abdullahbaig1618/LED-Dice/x540TyO4ae.png

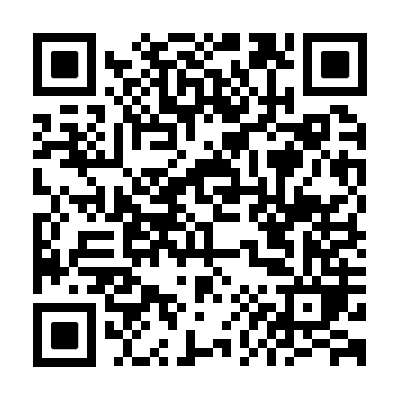
x540TyO4ae.png
