abdullahbaig1618/LED-Dice/casing/dice box.FCStd

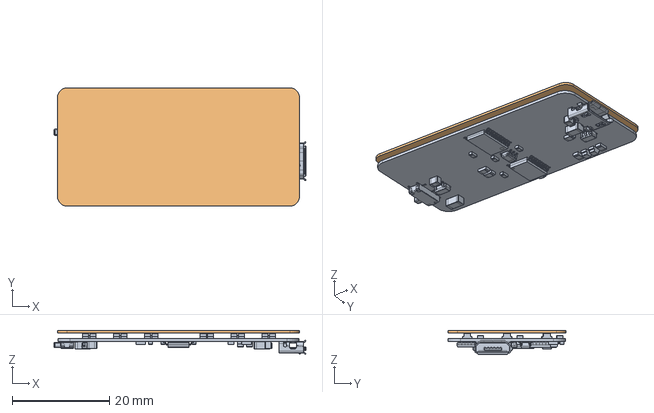
[picture p2: CAD file, 2025-08-02]
casing/dice box.FCStd
51.7 x 24.3 x 4.96 mm
board
