abdullahbaig1618/LED-Dice/circuits/LED Dice v1/LED Dice.step

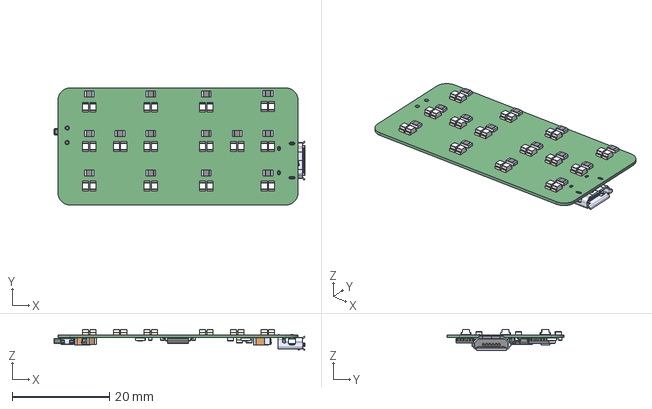
[picture p3: CAD file, 2026-06-17, an earlier design]
circuits/LED Dice v1/LED Dice.step
51.7 x 24.1 x 4.36 mm
