abdullahbaig1618/LED-Dice/circuits/LED Dice v2/LED Dice v2.pdf

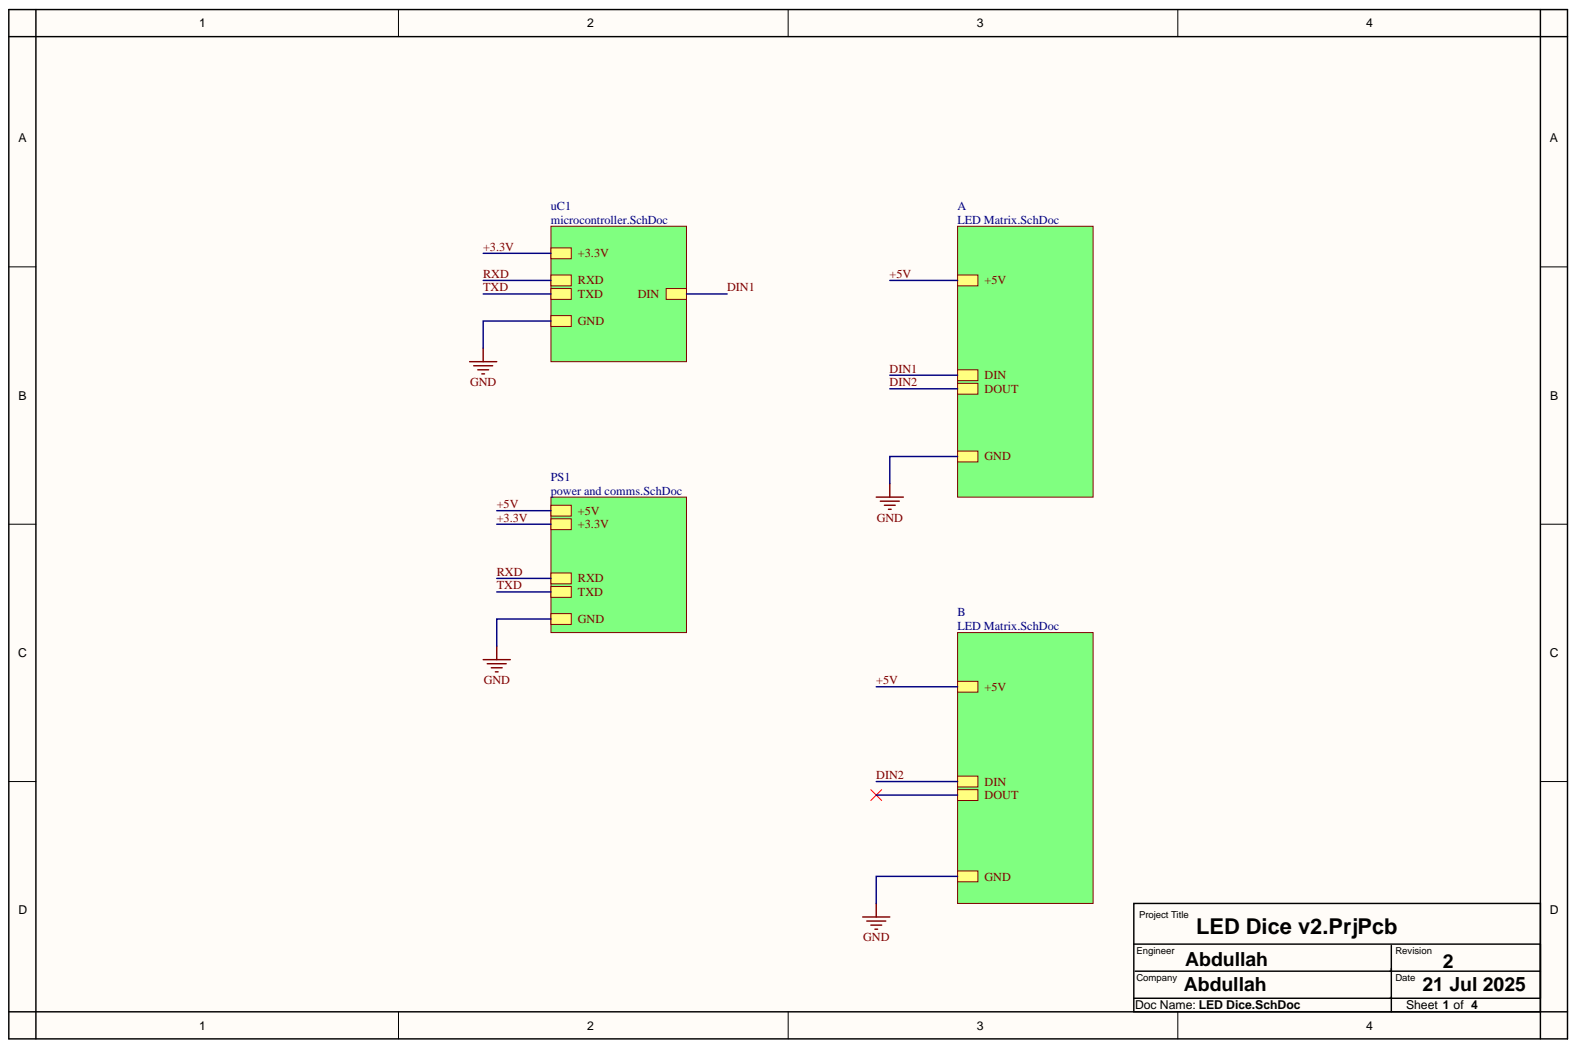
[picture p4: page 1]

A | uC1 A microcontroller.SchDoc LED Matrix.SchDoc | | | | A

LED Dice v2.PrjPcb Project Title

Engineer Abdullah | Revision
Company Abdullah | Sheet 1 of 4 2 Date 21 Jul 2025 Doc Name: LED Dice.SchDoc

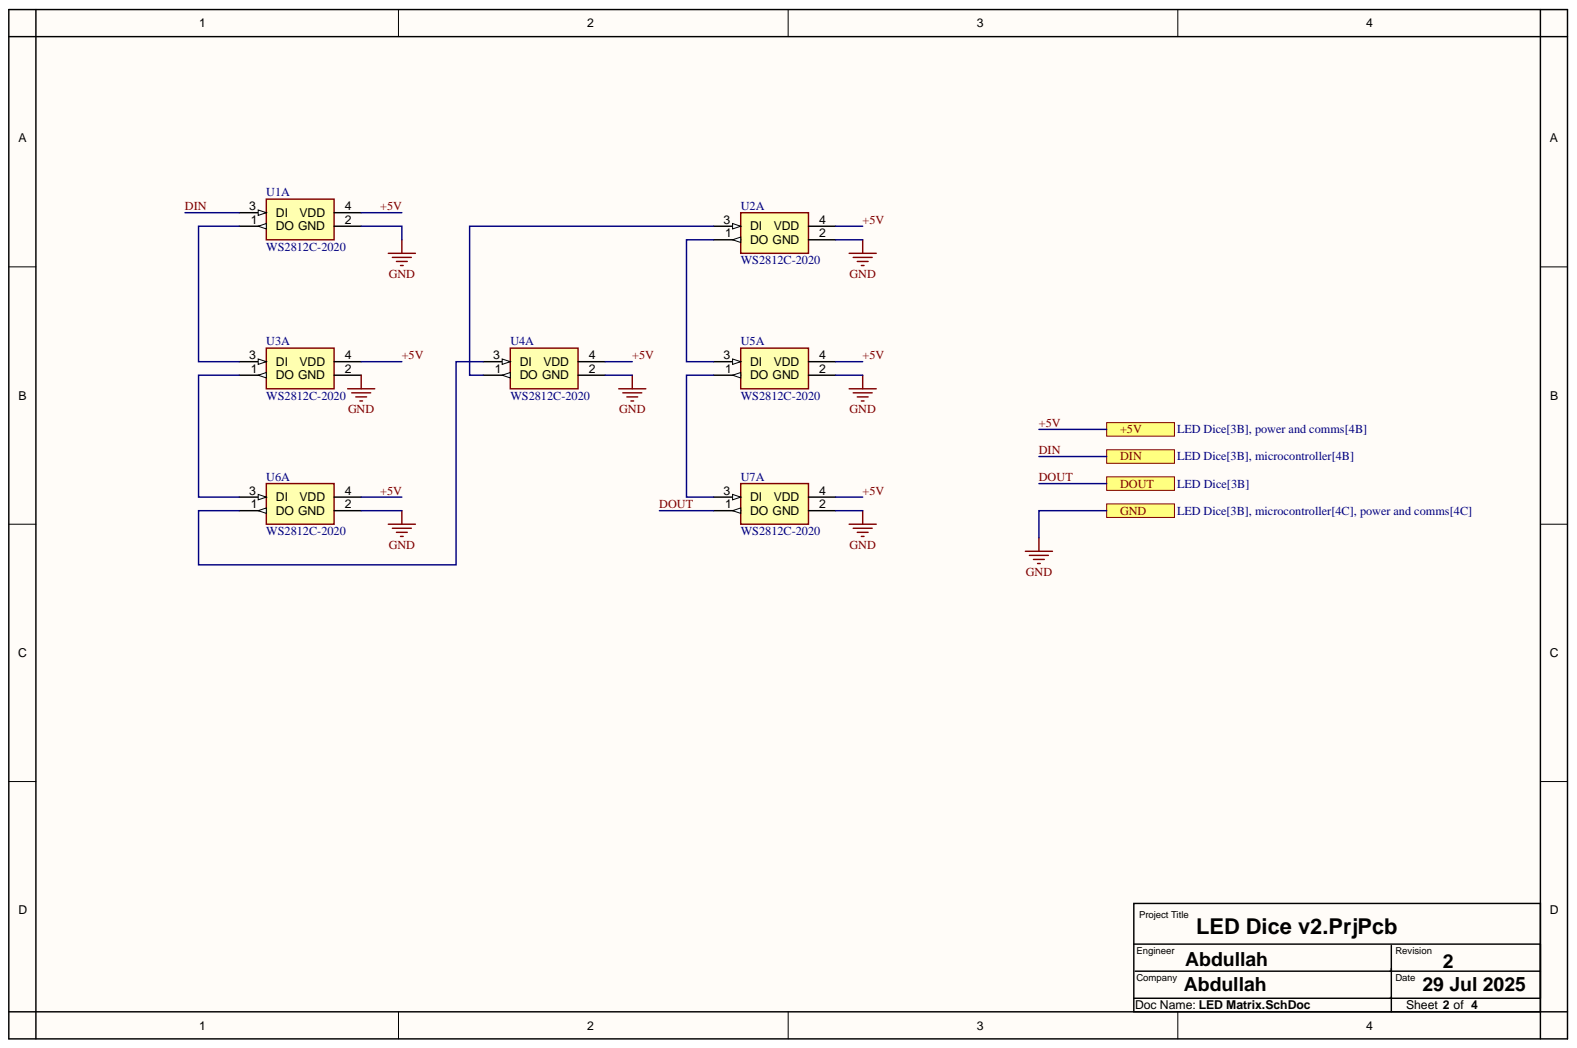
[picture p5: page 2]

LED Dice v2.PrjPcb Project Title

Engineer Abdullah | Revision
Company Abdullah | Sheet 2 of 4 2 Date 29 Jul 2025 Doc Name: LED Matrix.SchDoc

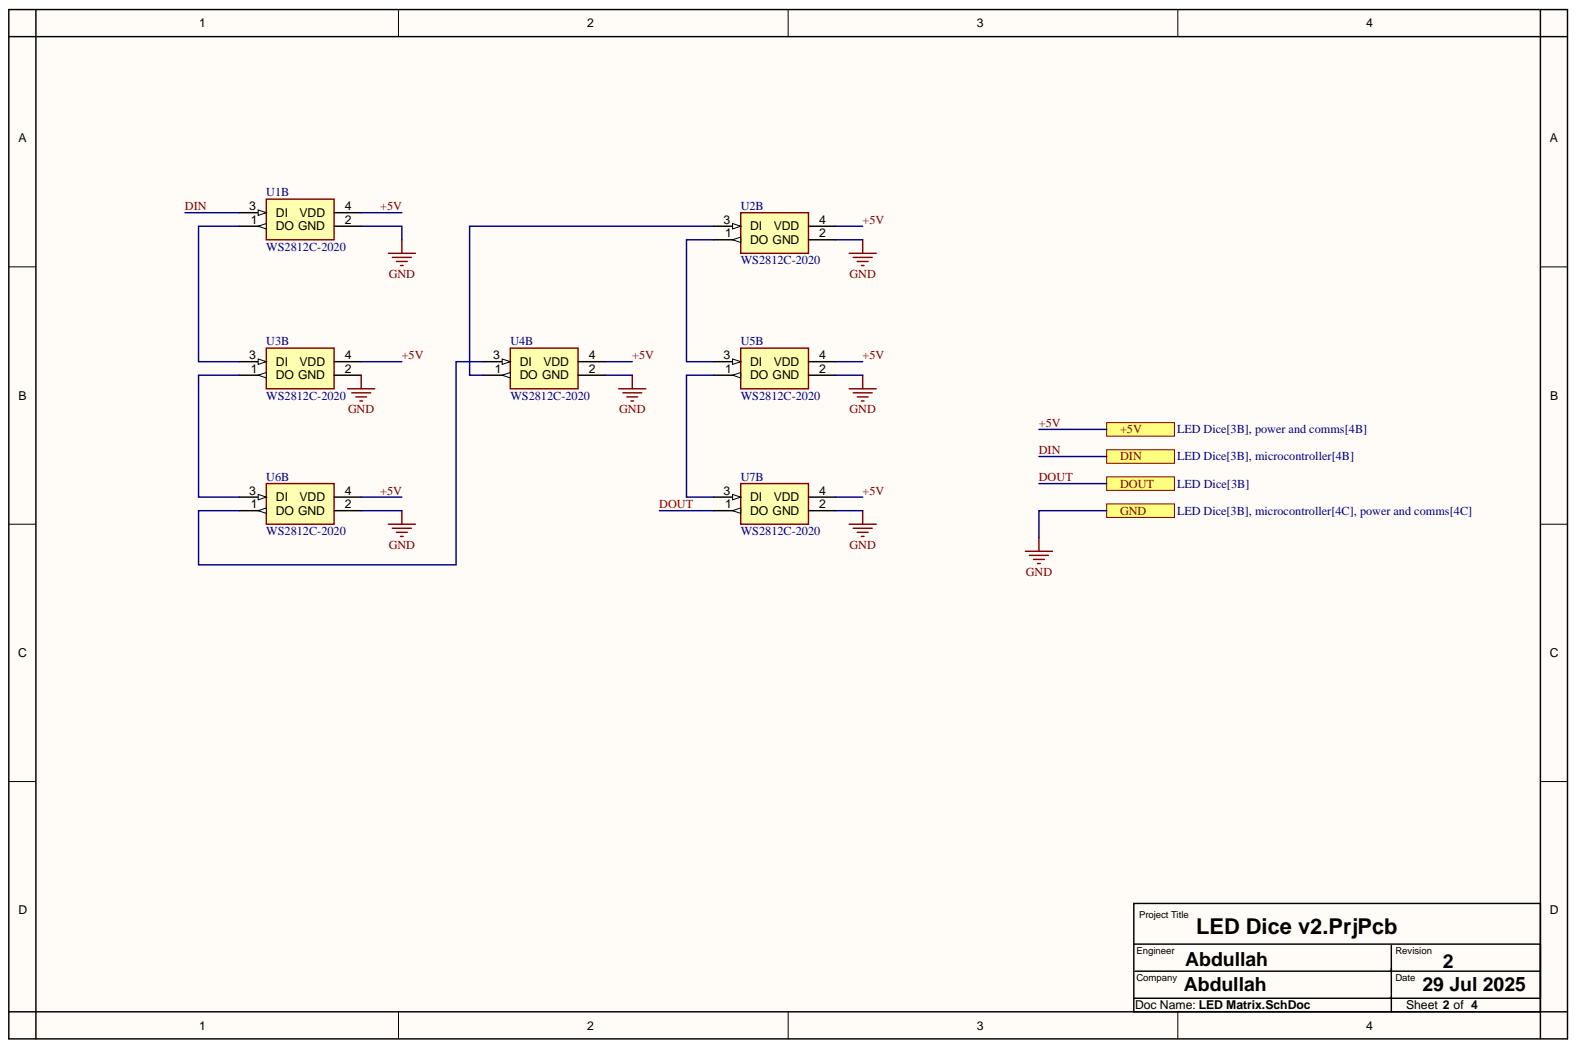
[picture p6: page 3]

LED Dice v2.PrjPcb Project Title

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

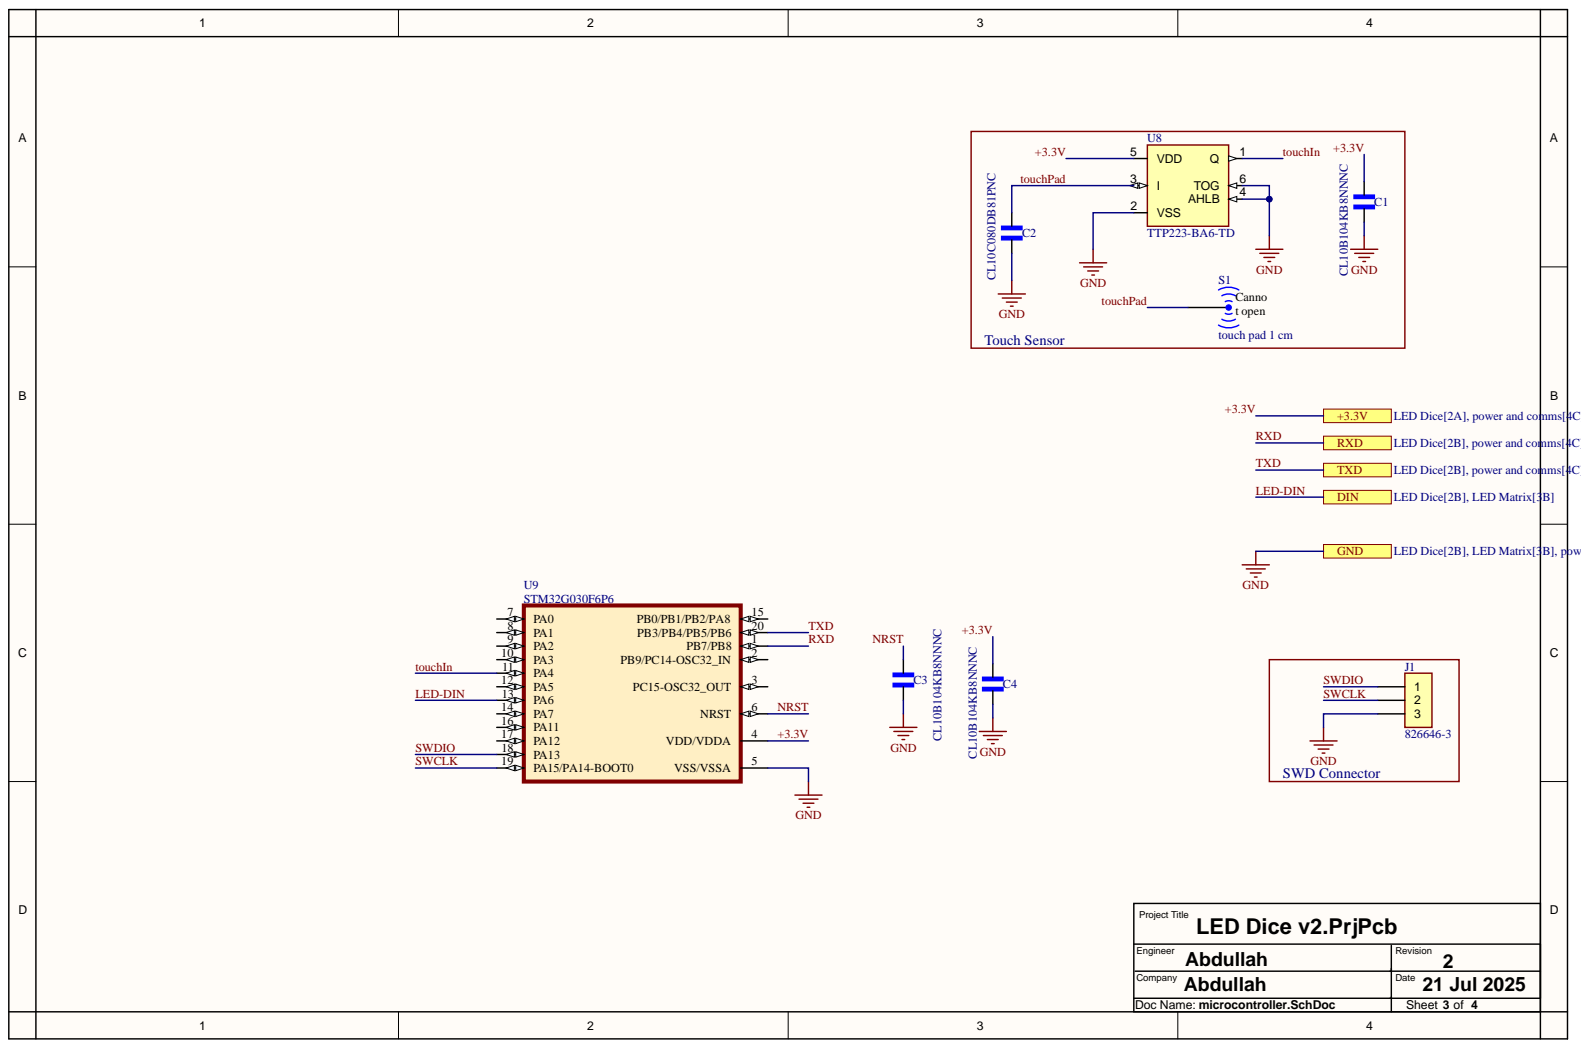
[picture p7: page 4]

LED Dice v2.PrjPcb Project Title

Engineer Abdullah | Revision
Company Abdullah | Sheet 3 of 4 2 Date 21 Jul 2025 Doc Name: microcontroller.SchDoc

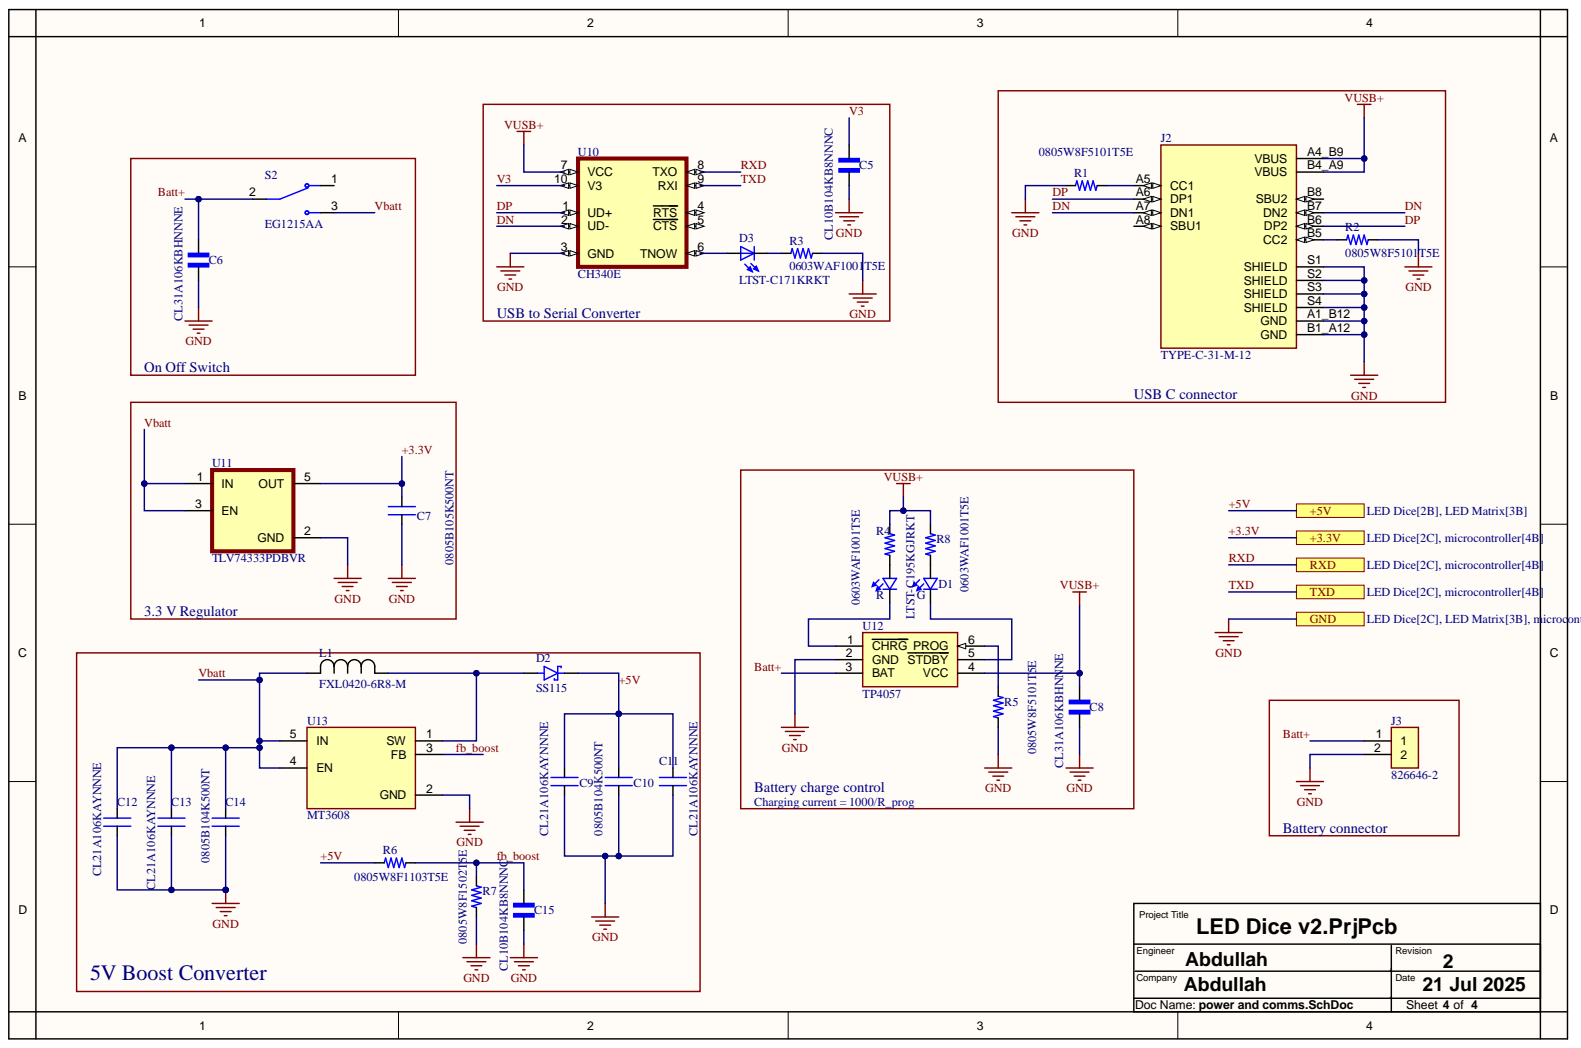
[picture p8: page 5]

USB to Serial Converter

CHRG 1 | STDBY
GND 2 | 5
BAT 3

LED Dice v2.PrjPcb Project Title

Engineer Abdullah | Revision
Company Abdullah | Sheet 4 of 4 2 Date 21 Jul 2025 Doc Name: power and comms.SchDoc

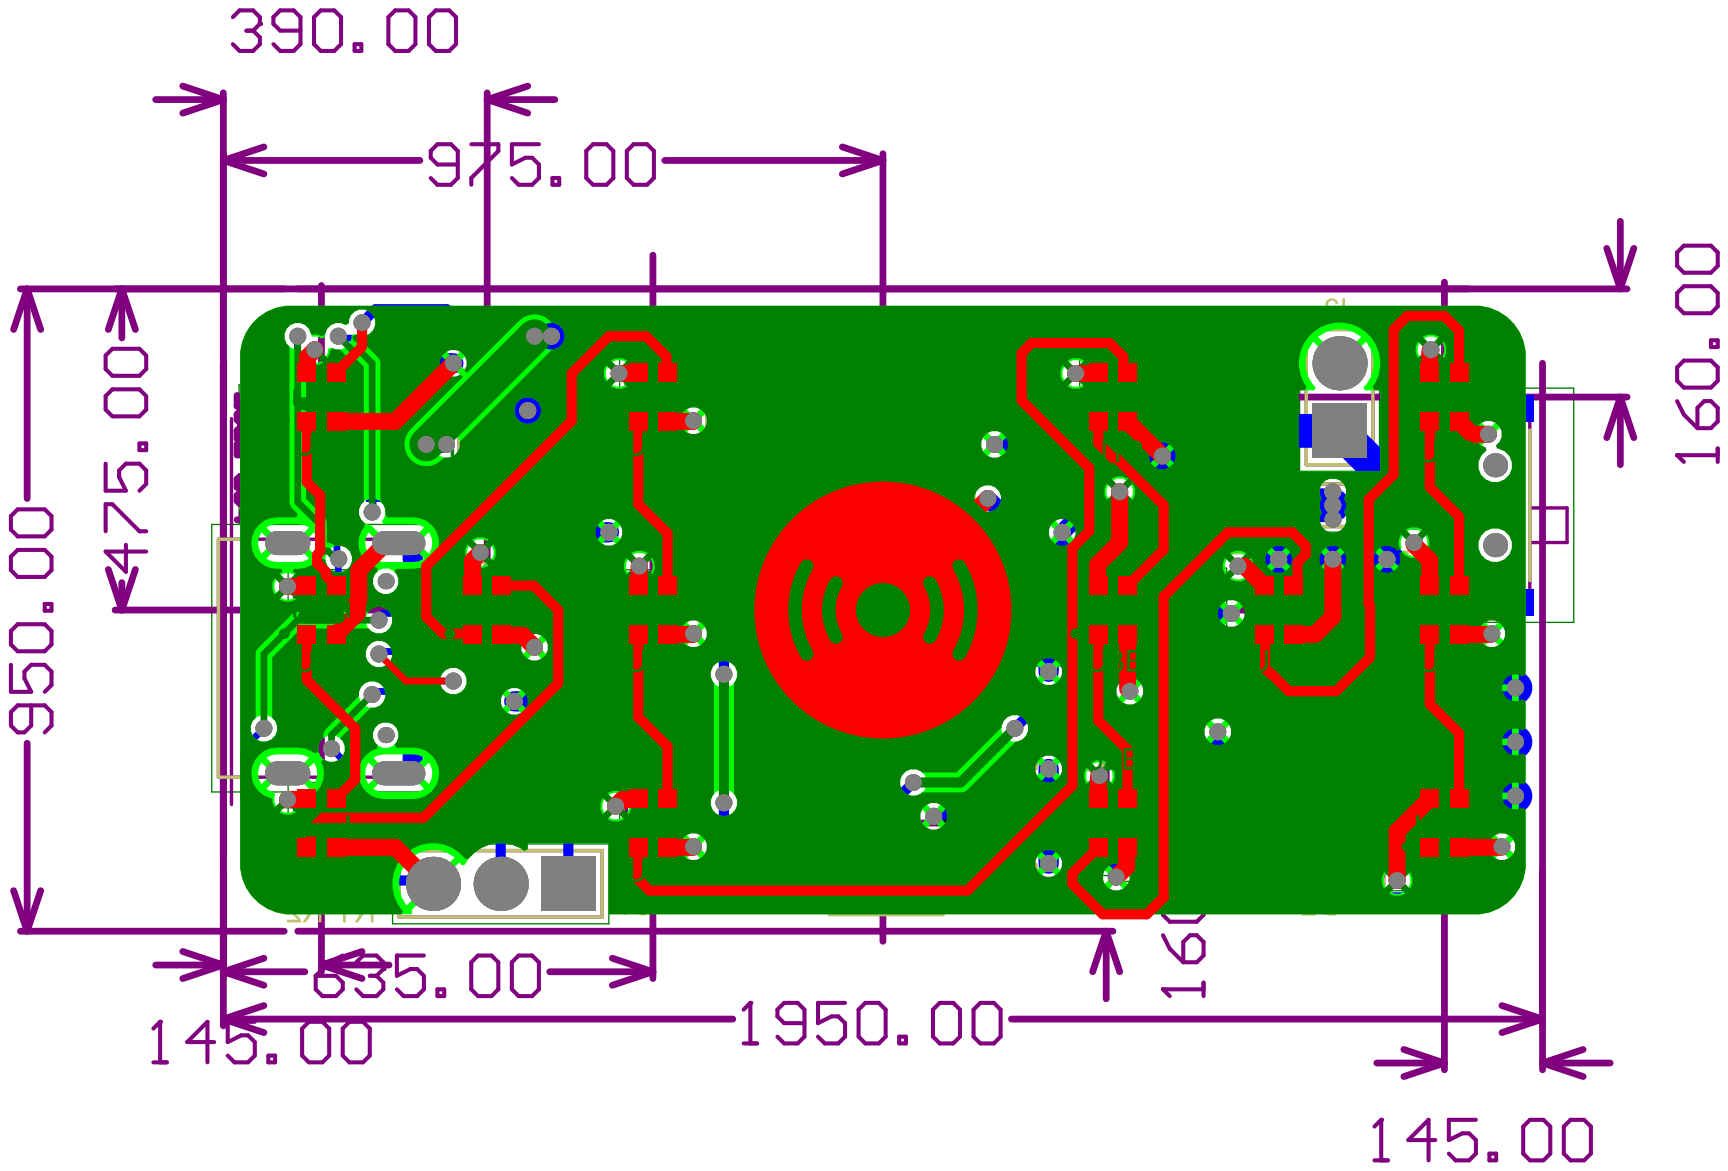
[picture p9: page 6]
