abdullahbaig1618/LED-Dice/(list of files, drawings)

Other design files:
circuits/LED Dice v1/LED Dice v1.PrjPcb
circuits/LED Dice v1/LED Dice.PcbDoc
circuits/LED Dice v1/LED Dice.SchDoc
circuits/LED Dice v1/LED Matrix.SchDoc
circuits/LED Dice v2/LED Dice v2.PrjPcb
circuits/LED Dice v2/LED Dice.PcbDoc
circuits/LED Dice v2/LED Dice.SchDoc
circuits/LED Dice v2/LED Matrix.SchDoc
circuits/LED Dice v2/microcontroller.SchDoc
circuits/LED Dice v2/power and comms.SchDoc
