abdullahbaig1618/LED-Dice/circuits/LED Dice v3/LED Dice/LED Dice.kicad_pcb

## KiCad design circuits/LED Dice v3/LED Dice/LED Dice.kicad_pcb (2026-06-24)

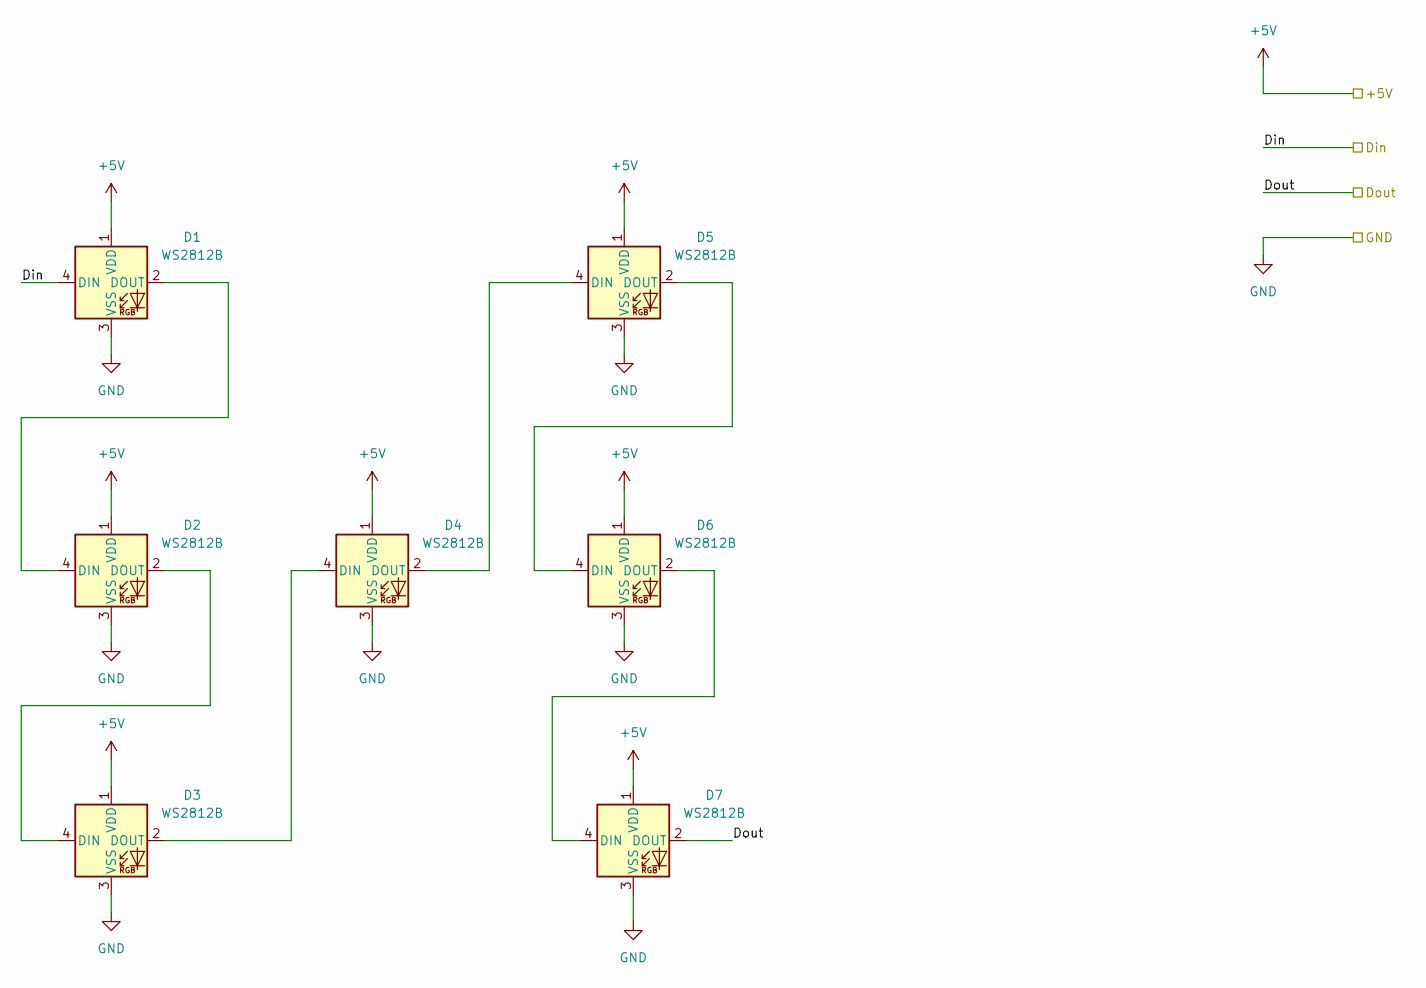
[picture p10: schematic led matrix.kicad_sch]

Parts:
D1, D2, D3, D4, D5, D6, D7: WS2812B; LED_WS2812B_PLCC4_5.0x5.0mm_P3.2mm; Part No WS2812B-B/W

Connections:
+5V: D1.1 (VDD), D2.1 (VDD), D3.1 (VDD), D4.1 (VDD), D5.1 (VDD), D6.1 (VDD), D7.1 (VDD); also elsewhere on the board
/LED Matrix 2/Din: D7.2 (DOUT); also elsewhere on the board
/LED matrix 1/Din: D1.4 (DIN); also elsewhere on the board
GND: D1.3 (VSS), D2.3 (VSS), D3.3 (VSS), D4.3 (VSS), D5.3 (VSS), D6.3 (VSS), D7.3 (VSS); also elsewhere on the board
unnamed: D1.2 (DOUT), D2.4 (DIN)
unnamed: D2.2 (DOUT), D3.4 (DIN)
unnamed: D3.2 (DOUT), D4.4 (DIN)
unnamed: D4.2 (DOUT), D5.4 (DIN)
unnamed: D5.2 (DOUT), D6.4 (DIN)
unnamed: D6.2 (DOUT), D7.4 (DIN)

Parts of its further copies:
D8, D9, D10, D11, D12, D13, D14: WS2812B; LED_WS2812B_PLCC4_5.0x5.0mm_P3.2mm; Part No WS2812B-B/W

Connections of its further copies:
+5V: D8.1 (VDD), D9.1 (VDD), D10.1 (VDD), D11.1 (VDD), D12.1 (VDD), D13.1 (VDD), D14.1 (VDD); also elsewhere on the board
/LED Matrix 2/Din: D8.4 (DIN); also elsewhere on the board
/LED Matrix 2/Dout: D14.2 (DOUT)
GND: D8.3 (VSS), D9.3 (VSS), D10.3 (VSS), D11.3 (VSS), D12.3 (VSS), D13.3 (VSS), D14.3 (VSS); also elsewhere on the board
unnamed: D8.2 (DOUT), D9.4 (DIN)
unnamed: D9.2 (DOUT), D10.4 (DIN)
unnamed: D10.2 (DOUT), D11.4 (DIN)
unnamed: D11.2 (DOUT), D12.4 (DIN)
unnamed: D12.2 (DOUT), D13.4 (DIN)
unnamed: D13.2 (DOUT), D14.4 (DIN)

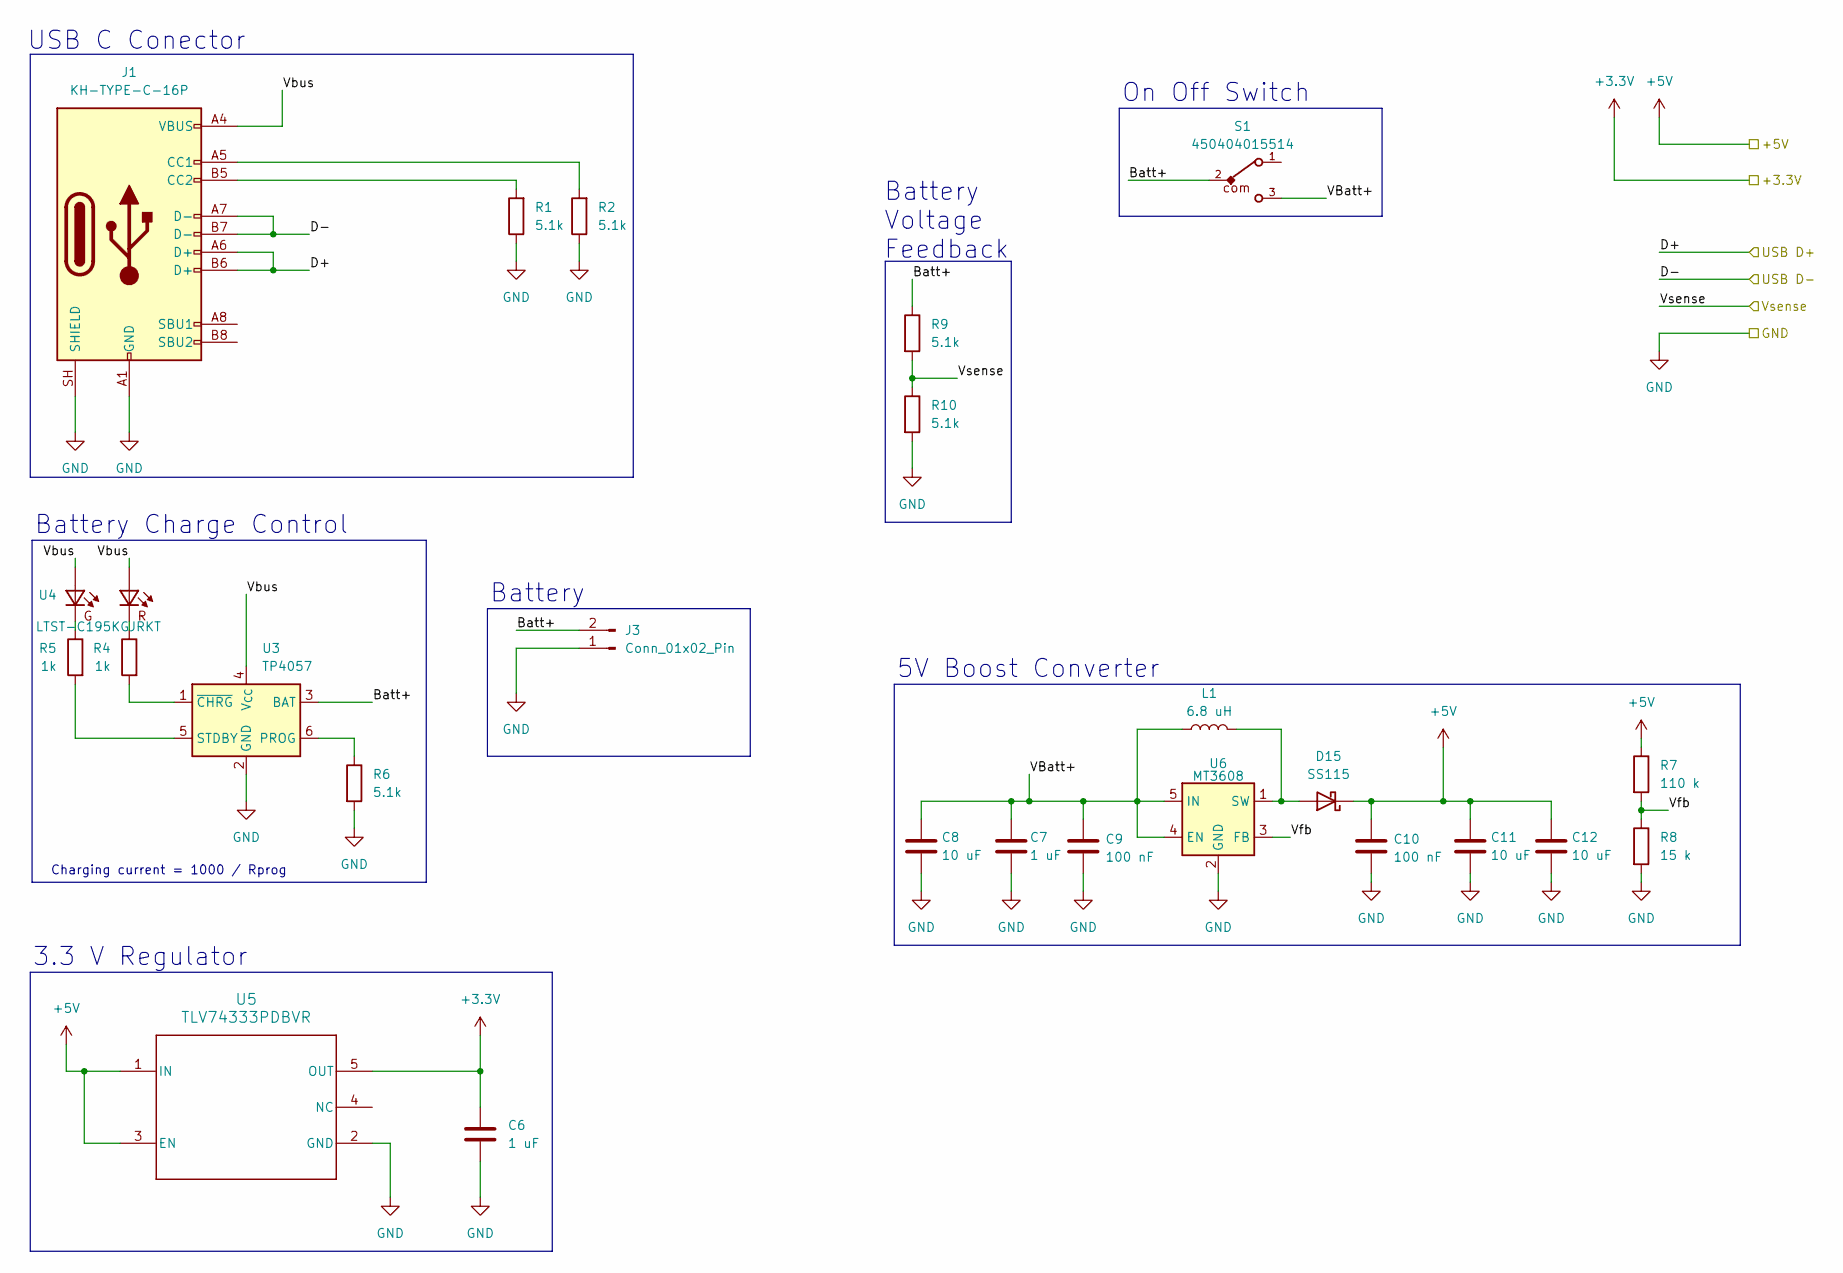
[picture p11: schematic power and comms.kicad_sch]

Parts:
C6: 1 uF; C_0603_1608Metric_Pad1.08x0.95mm_HandSolder; Part No CL10B105KB8NQNC
C7: 1 uF; C_0805_2012Metric_Pad1.18x1.45mm_HandSolder; Part No CL21B105KBFNNNE
C8, C12: 10 uF; C_1206_3216Metric_Pad1.33x1.80mm_HandSolder; Part No CL31A106KAHNNNE
C9, C10: 100 nF; C_0603_1608Metric_Pad1.08x0.95mm_HandSolder; Part No CL10B104KB8NNNC
C11: 10 uF; C_0805_2012Metric_Pad1.18x1.45mm_HandSolder; Part No CL31A106KAHNNNE
D15: SS115; D_SMA_Handsoldering; Part No SS115
J1: KH-TYPE-C-16P; USB_C_Receptacle_GCT_USB4105-xx-A_16P_TopMnt_Horizontal; Part No KH-TYPE-C-16P
J3: Conn_01x02_Pin; PinHeader_1x02_P2.54mm_Vertical; Part No PZ254V-11-02P
L1: 6.8 uH; L_Changjiang_FXL0412; Part No FXL0420-6R8-M
R1: 5.1k; R_0603_1608Metric; Part No FRC0603F5101TS
R2, R6, R9, R10: 5.1k; R_0603_1608Metric_Pad0.98x0.95mm_HandSolder; Part No FRC0603F5101TS
R4, R5: 1k; R_0603_1608Metric_Pad0.98x0.95mm_HandSolder; Part No FRC0603F1001TS
R7: 110 k; R_0603_1608Metric_Pad0.98x0.95mm_HandSolder; Part No FRC0603F1103TS
R8: 15 k; R_0603_1608Metric_Pad0.98x0.95mm_HandSolder; Part No FRC0603F1502TS
S1: 450404015514; Part No MK-12C02-G020
U3: TP4057; TSOT-23-6; Part No TP4057
U4: LTST-C195KGJRKT; LTST-BILED-15X16; Part No LTST-C195KGJRKT
U5: TLV74333PDBVR; DBV0005A_M; Part No TLV74333PDBVR
U6: MT3608; SOT-23-6; Part No MT3608

Connections:
+3.3V: C6.1, U5.5 (OUT); also elsewhere on the board
+5V: C10.1, C11.1, C12.1, D15.1 (K), R7.1, U5.1 (IN), U5.3 (EN); also elsewhere on the board
/Microcontroller/USB D+: J1.A6 (D+), J1.B6 (D+); also elsewhere on the board
/Microcontroller/USB D-: J1.A7 (D-), J1.B7 (D-); also elsewhere on the board
/Microcontroller/Vsample: R9.2, R10.1; also elsewhere on the board
/Power and Comms/Batt+: J3.2, R9.1, S1.2, U3.3 (BAT)
/Power and Comms/VBatt+: C7.1, C8.1, C9.1, L1.1, S1.3, U6.4 (EN), U6.5 (IN)
/Power and Comms/Vbus: J1.A4 (VBUS), J1.A9 (VBUS), J1.B4 (VBUS), J1.B9 (VBUS), U3.4 (V_{CC}), U4.P$1, U4.P$2
/Power and Comms/Vfb: R7.2, R8.1, U6.3 (FB)
GND: C6.2, C7.2, C8.2, C9.2, C10.2, C11.2, C12.2, J1.A1 (GND), J1.A12 (GND), J1.B1 (GND), J1.B12 (GND), J1.SH (SHIELD), J3.1, R1.1, R2.1, R6.2, R8.2, R10.2, U3.2 (GND), U5.2 (GND), U6.2 (GND); also elsewhere on the board
unnamed: D15.2 (A), L1.2, U6.1 (SW)
unnamed: J1.A5 (CC1), R2.2
unnamed: J1.B5 (CC2), R1.2
unnamed: R4.1, U4.P$4
unnamed: R5.1, U4.P$3
unnamed: R6.1, U3.6 (PROG)
unnamed: R5.2, U3.5 (STDBY)
unnamed: R4.2, U3.1 (~CHRG)

Notes on the sheet:
Charging current = 1000 / Rprog
Battery Voltage Feedback
5V Boost Converter
Battery
On Off Switch
Battery Charge Control
USB C Conector
3.3 V Regulator

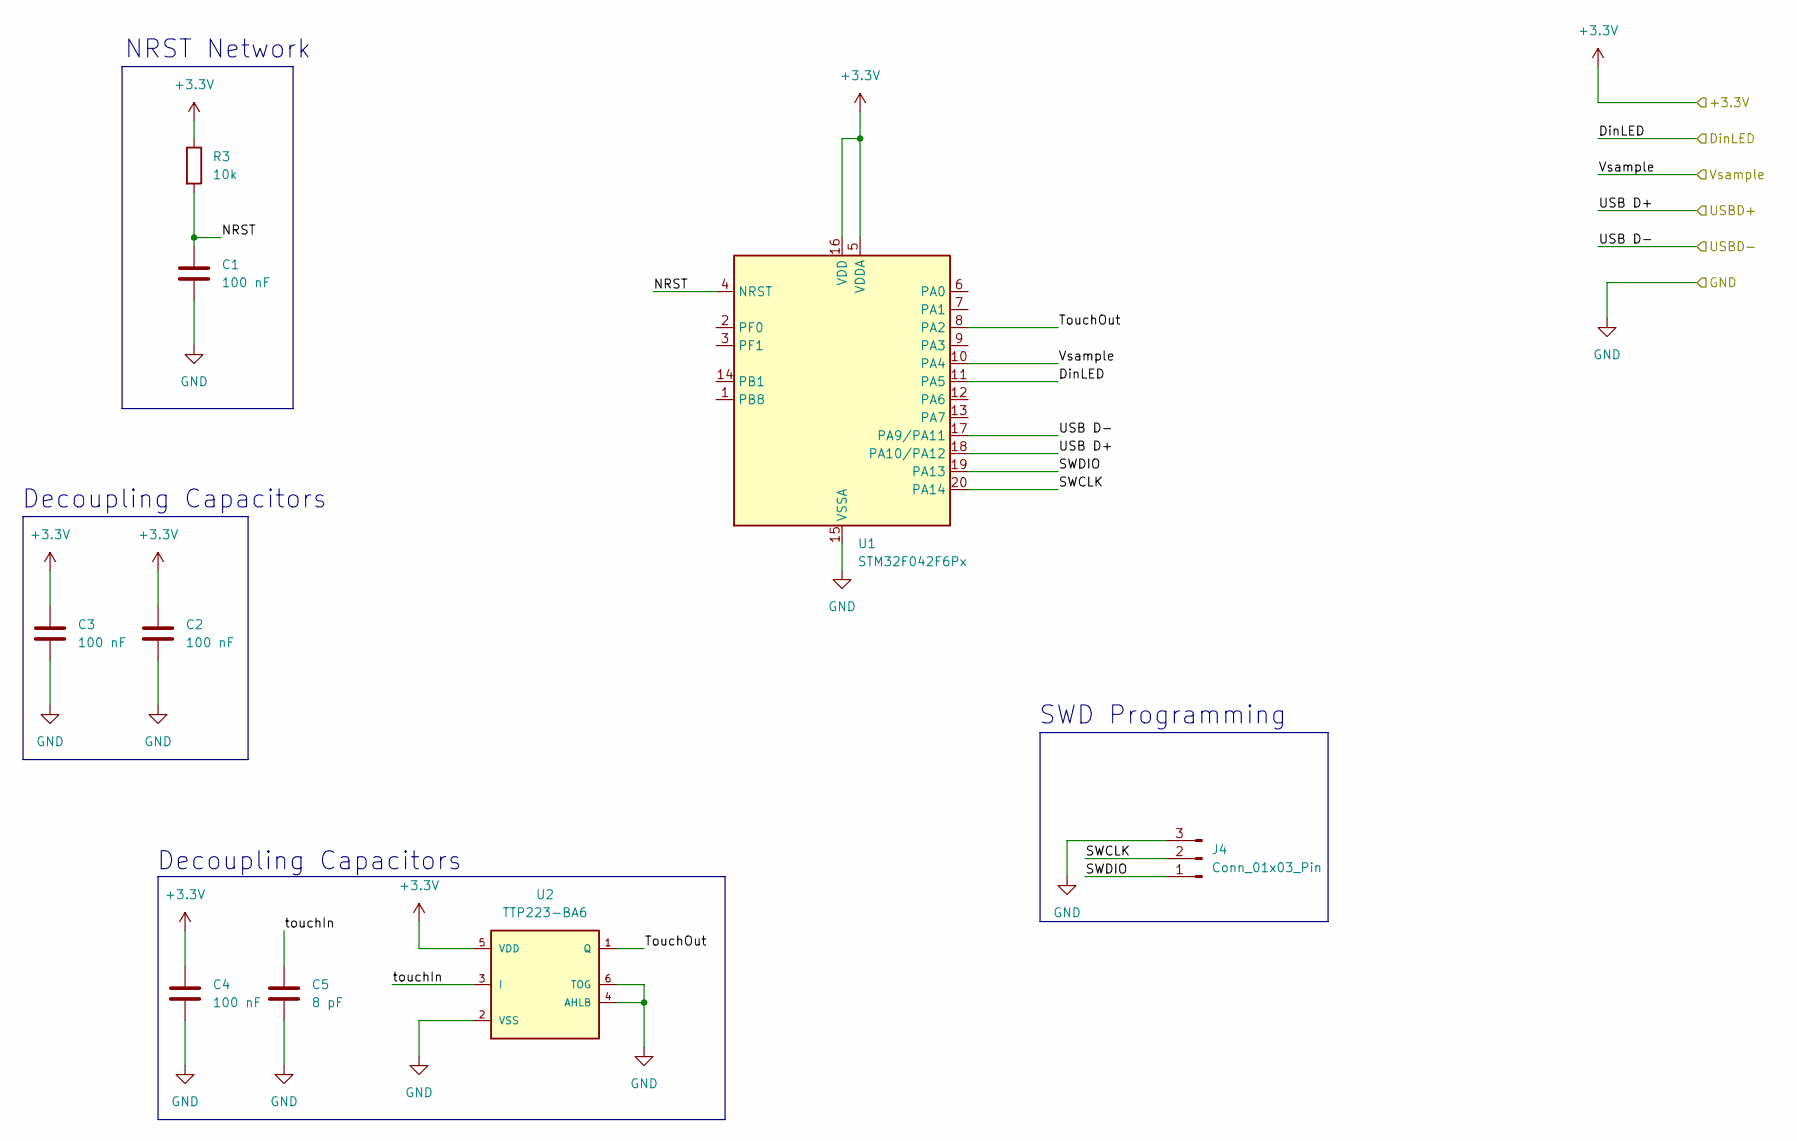
[picture p12: schematic microcontroller.kicad_sch]

Parts:
C1, C2, C3, C4: 100 nF; C_0603_1608Metric_Pad1.08x0.95mm_HandSolder; Part No CL10B104KB8NNNC
C5: 8 pF; C_0603_1608Metric_Pad1.08x0.95mm_HandSolder; Part No CL10C080DB81PNC
J4: Conn_01x03_Pin; PinHeader_1x03_P2.54mm_Vertical; Part No HX PZ2.54-1x4P ZZ
R3: 10k; R_0603_1608Metric_Pad0.98x0.95mm_HandSolder; Part No FRC0603J103 TS
U1: STM32F042F6Px; TSSOP-20_4.4x6.5mm_P0.65mm; Part No STM32F042F6P6TR
U2: TTP223-BA6; SOT23-6; Part No TTP223-BA6

Connections:
+3.3V: C2.1, C3.1, C4.1, R3.1, U1.5 (VDDA), U1.16 (VDD), U2.5 (VDD); also elsewhere on the board
/LED matrix 1/Din: U1.11 (PA5); also elsewhere on the board
/Microcontroller/NRST: C1.1, R3.2, U1.4 (NRST)
/Microcontroller/SWCLK: J4.2, U1.20 (PA14)
/Microcontroller/SWDIO: J4.1, U1.19 (PA13)
/Microcontroller/TouchOut: U1.8 (PA2), U2.1 (Q)
/Microcontroller/USB D+: U1.18 (PA10/PA12); also elsewhere on the board
/Microcontroller/USB D-: U1.17 (PA9/PA11); also elsewhere on the board
/Microcontroller/Vsample: U1.10 (PA4); also elsewhere on the board
/Microcontroller/touchIn: C5.1, U2.3 (I)
GND: C1.2, C2.2, C3.2, C4.2, C5.2, J4.3, U1.15 (VSSA), U2.2 (VSS), U2.4 (AHLB), U2.6 (TOG); also elsewhere on the board

Notes on the sheet:
Decoupling Capacitors
SWD Programming
NRST Network

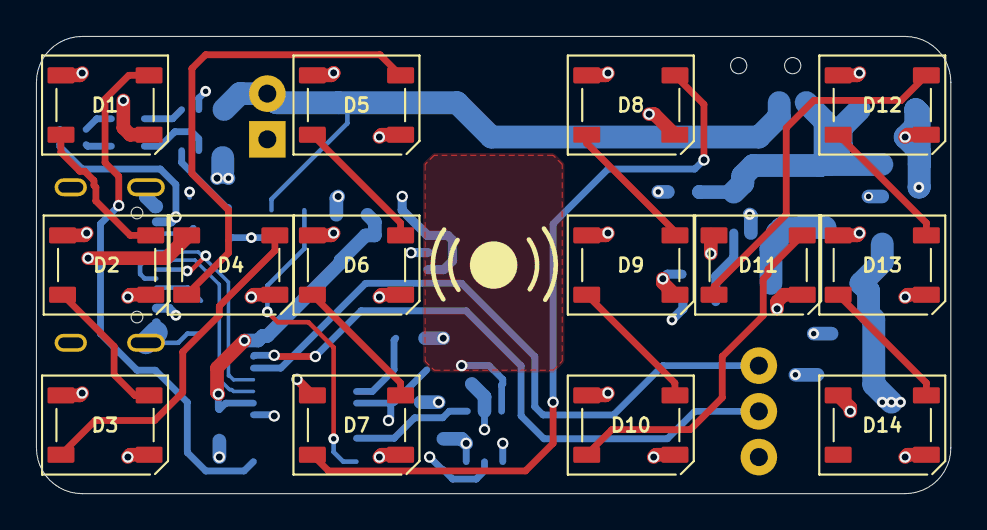
[picture p13: board LED Dice.kicad_pcb from above]

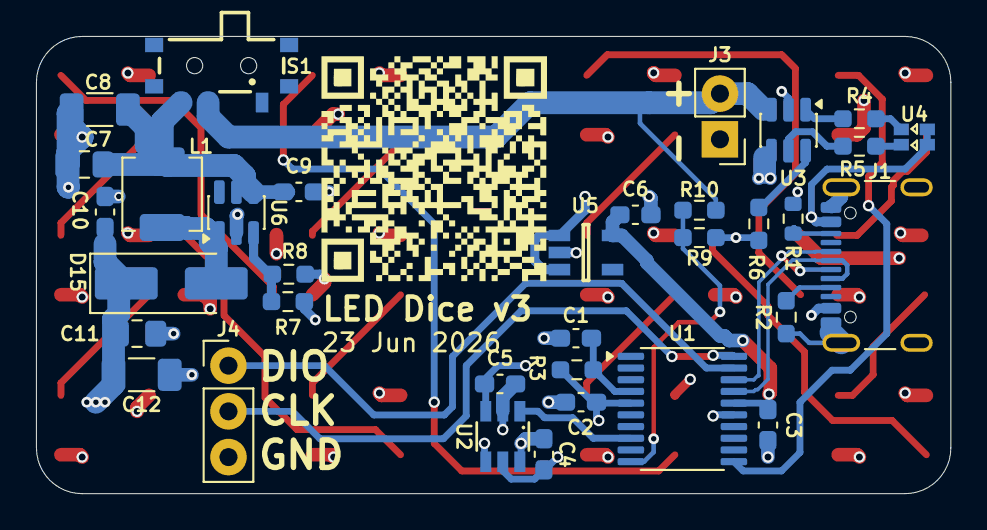
[picture p14: board LED Dice.kicad_pcb from below]

Board: 4 copper layers, 50.8 x 25.4 mm, 48 parts (34 on the bottom side), 37 nets.
