abdullahbaig1618/LED-Dice/programs/LED Dice G0B1/LED_Dice_G0B1.ioc

Mcu.UserName=STM32G0B1CBTx
PA0.Signal=S_TIM2_CH1_ETR
PA13.Signal=SYS_SWDIO
PA14-BOOT0.Signal=SYS_SWCLK
PA4.GPIO_Label=Vbatt
PA4.Signal=ADC1_IN4
