abdullahbaig1618/LED-Dice/programs/LED_Dice_F042/Core/Inc/main.h

#define touch_Pin GPIO_PIN_2
#define touch_GPIO_Port GPIOA
#define Vbatt_Pin GPIO_PIN_4
#define Vbatt_GPIO_Port GPIOA
