abdullahbaig1618/LED-Dice/(commit log)

2025-08-02 Add existing files
    [LED Dice v1.PrjPcb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]
2025-08-02 Initial files upload
    [LED Dice v1.PrjPcb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]
2025-08-02 gerbers generated
    [LED Dice v2.PrjPcb, LED Dice.PcbDoc]
2025-08-02 libraries corrected to latest components, BOM updated
    [LED Dice v2.PrjPcb, LED Dice.PcbDoc, LED Matrix.SchDoc, microcontroller.SchDoc, power and comms.SchDoc]
2026-06-17 modified G030 code for WS2812C
    [LED Dice v1.PrjPcb, LED Dice v2.PrjPcb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]
2026-06-20 generated schematic
    [LED Dice v2.PrjPcb]
2026-06-20 Make project in Kicad, use microcontroller capable of USB comms
    [LED Dice.kicad_pcb, LED Dice.kicad_sch, led matrix.kicad_sch, microcontroller.kicad_sch, power and comms.kicad_sch]
2026-06-22 schematic is complete
    [LED Dice.kicad_sch, power and comms.kicad_sch]
2026-06-22 layout progress
    [LED Dice.kicad_pcb, LED Dice.kicad_sch, led matrix.kicad_sch, microcontroller.kicad_sch, power and comms.kicad_sch]
2026-06-22 layout complete, some DRC violations are present
    [LED Dice.kicad_pcb, power and comms.kicad_sch]
2026-06-22 All meaningful DRC resolved
    [LED Dice.kicad_pcb]
2026-06-24 gerbers and BOM generated
    [LED Dice BOM.csv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]
2026-07-18 added BOM
    [LED Dice BOM.csv, power and comms.kicad_sch]
