abdullahbaig1618/LED-Dice/(notices)

Notices in the files:
programs/LED Dice G030/Core/Src/main.c:
Copyright (c) 2025 STMicroelectronics.
All rights reserved.
This software is licensed under terms that can be found in the LICENSE file
programs/LED_Dice_F042/Core/Inc/main.h:
Copyright (c) 2026 STMicroelectronics.
